olivia-dicorpo/birdfeeder/cad/README.md

# CAD

| Folder | What to open |
|---|---|
| `fusion/` | Fusion 360 `.f3z` / `.f3d` (source assemblies and body) |
| `step/` | Latest part exports for CAD interchange |
| `stl/` | Mesh exports for preview / print |
| `vendor/` | Bought-part models (SG90, McMaster torsion springs) |

See [docs/hardware.md](../docs/hardware.md) for the bill of materials and bounding-box sizes.
