olivia-dicorpo/birdfeeder/cad/step/spring-arm-left.step

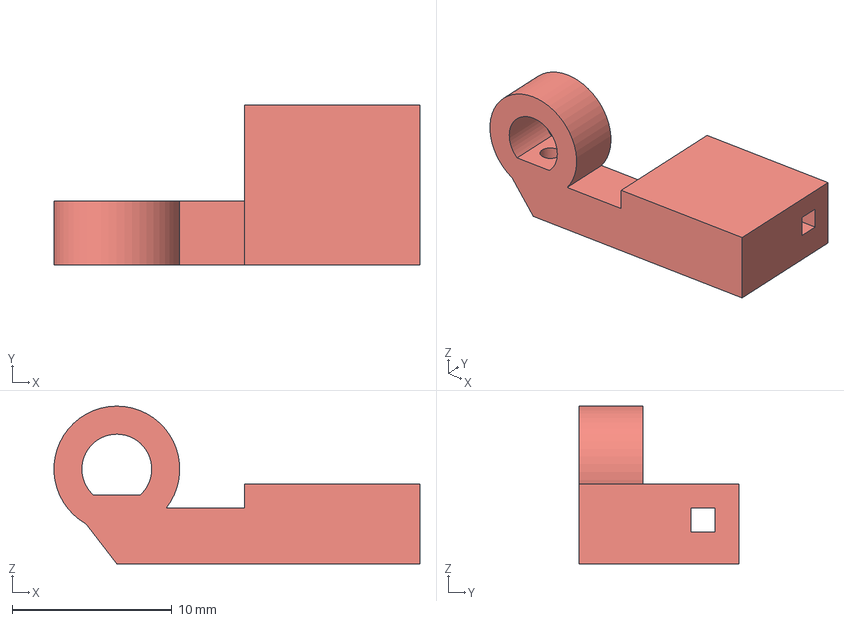
[picture p2: CAD file, 2026-10-11]
cad/step/spring-arm-left.step
22.9 x 10.0 x 9.89 mm
