olivia-dicorpo/birdfeeder/cad/stl/perch-new.stl

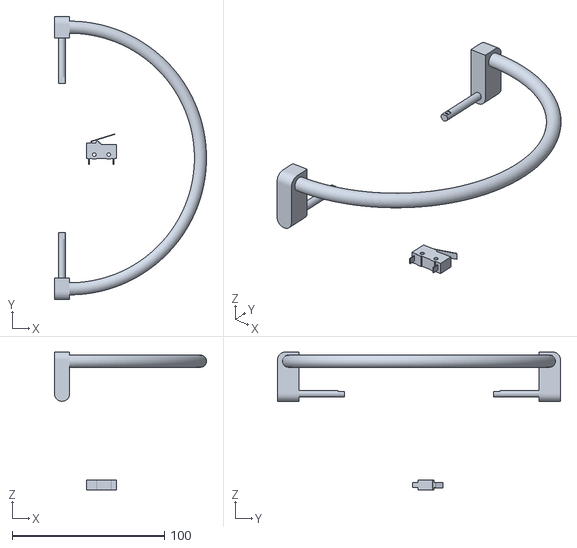
[picture p3: CAD file, 2026-10-11]
cad/stl/perch-new.stl
99.9 x 185.9 x 90.6
