olivia-dicorpo/birdfeeder/cad/step/base.step

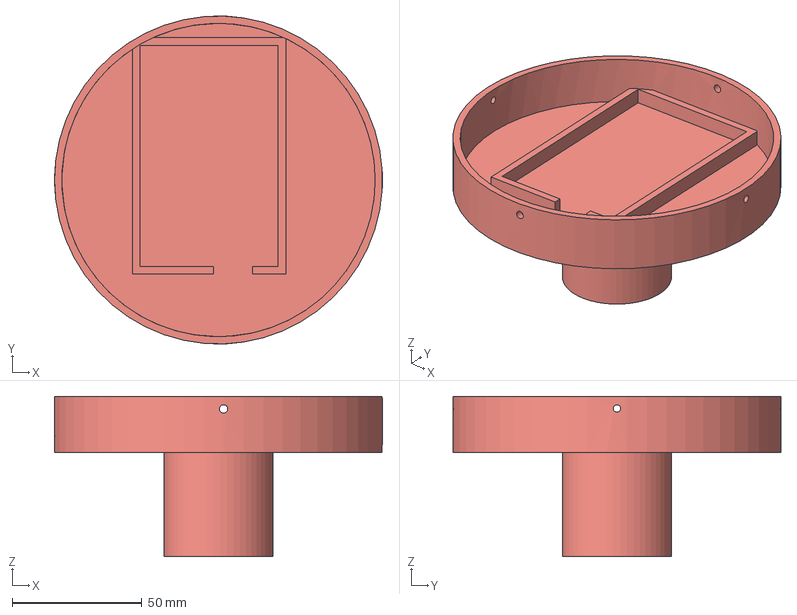
[picture p4: CAD file, 2026-10-11]
cad/step/base.step
126.2 x 126.2 x 61.7 mm
