olivia-dicorpo/birdfeeder/cad/stl/perch.stl

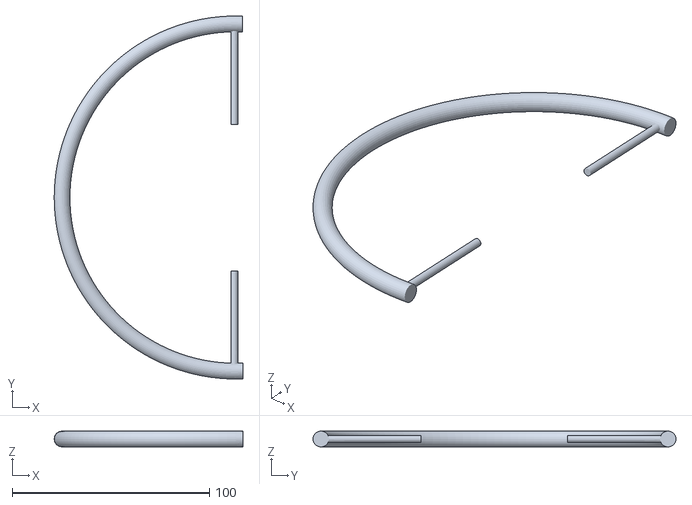
[picture p5: CAD file, 2026-10-11]
cad/stl/perch.stl
95.6 x 184.0 x 8.00
