olivia-dicorpo/birdfeeder/cad/step/perch-left.step

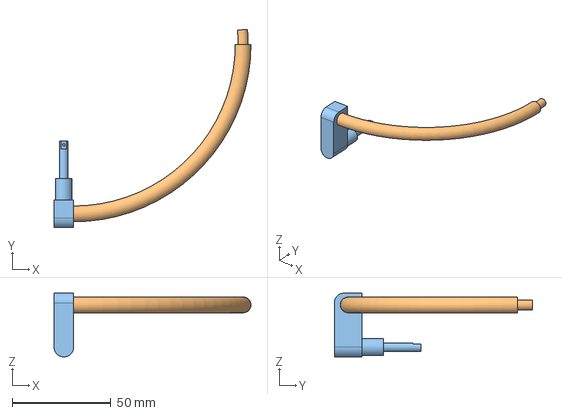
[picture p6: CAD file, 2026-10-11]
cad/step/perch-left.step
99.9 x 100.6 x 32.4 mm
