olivia-dicorpo/birdfeeder/cad/step/body-correct.step

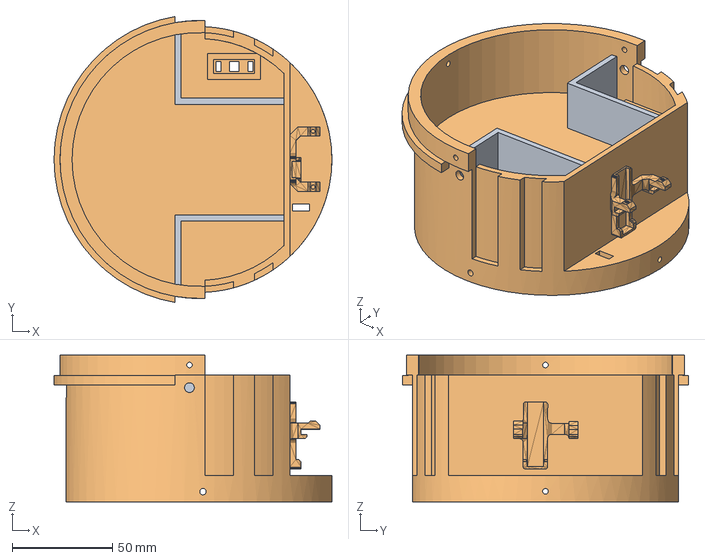
[picture p7: CAD file, 2026-10-11]
cad/step/body-correct.step
138.6 x 142.6 x 73.3 mm
