olivia-dicorpo/birdfeeder/cad/step/roof.step

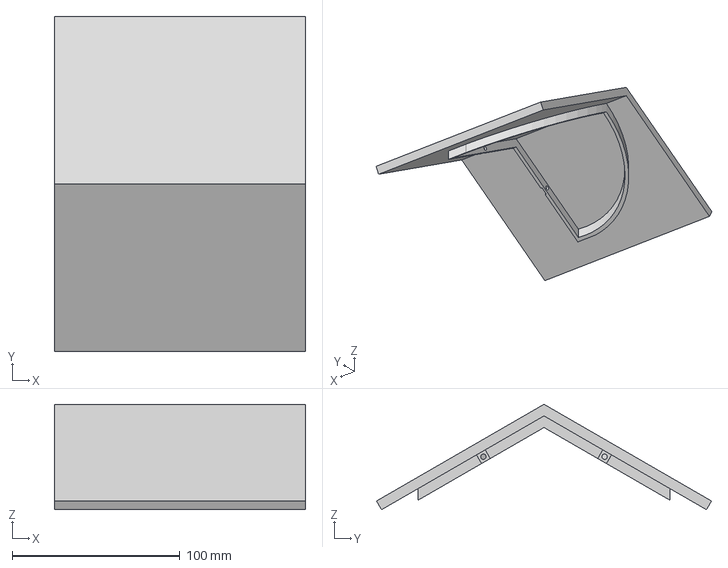
[picture p8: CAD file, 2026-10-11]
cad/step/roof.step
150.0 x 200.0 x 62.9 mm
