olivia-dicorpo/birdfeeder/cad/step/spring-arm-right.step

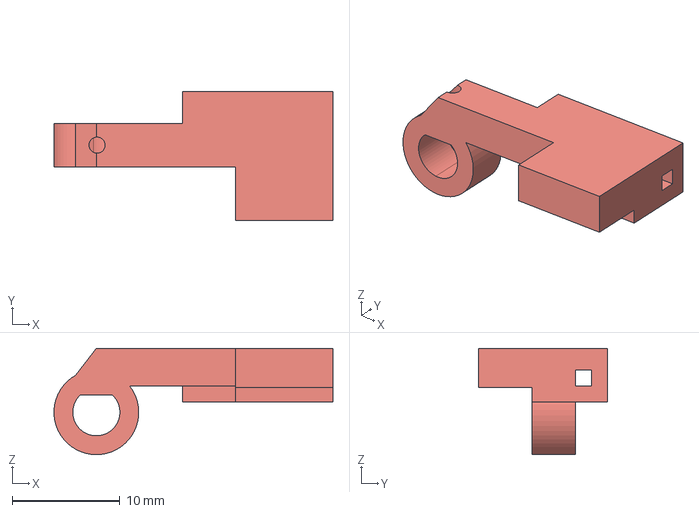
[picture p9: CAD file, 2026-10-11]
cad/step/spring-arm-right.step
25.9 x 12.0 x 9.89 mm
