olivia-dicorpo/birdfeeder/cad/step/perch-right.step

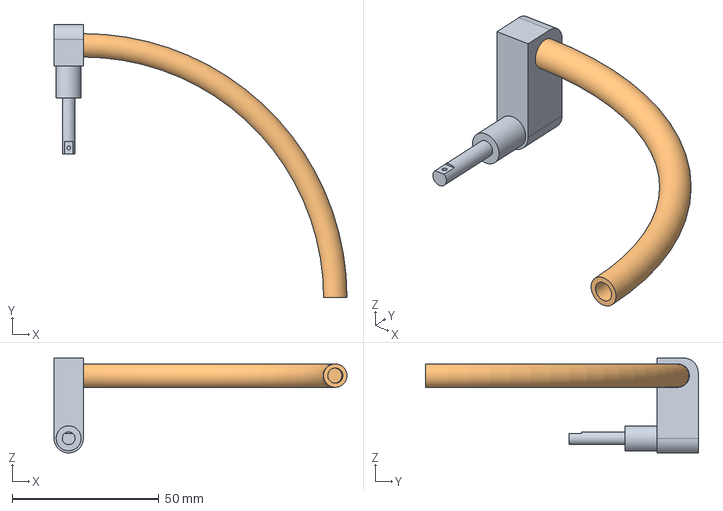
[picture p10: CAD file, 2026-10-11]
cad/step/perch-right.step
99.9 x 92.9 x 32.4 mm
