olivia-dicorpo/birdfeeder/cad/step/clear-seed-storage.step

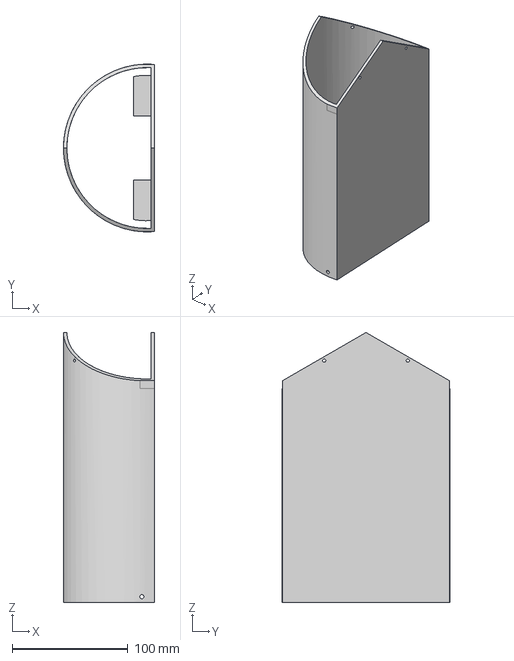
[picture p11: CAD file, 2026-10-11]
cad/step/clear-seed-storage.step
78.9 x 145.1 x 233.7 mm
