olivia-dicorpo/birdfeeder/cad/step/lid-correct.step

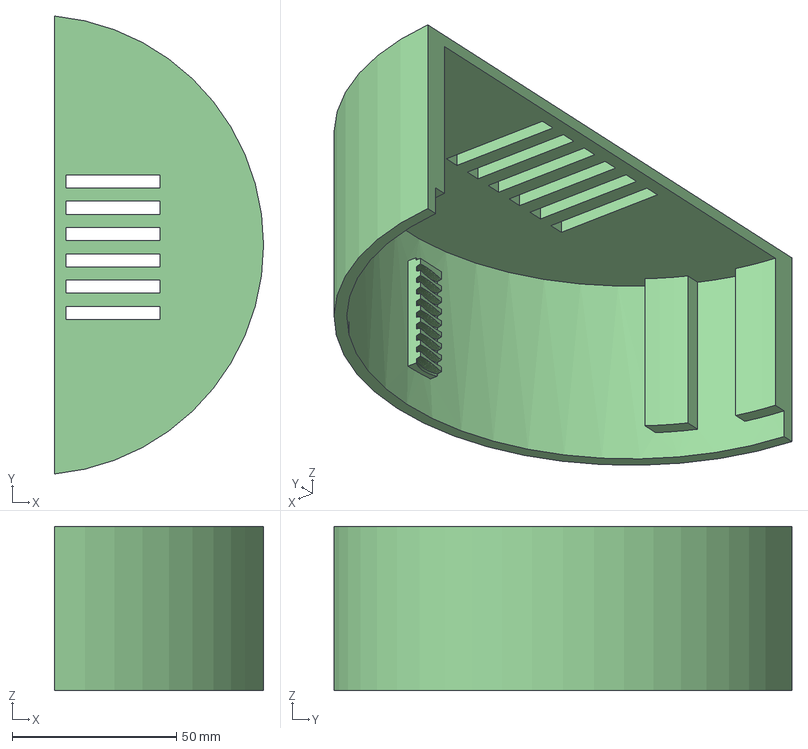
[picture p12: CAD file, 2026-10-11]
cad/step/lid-correct.step
63.7 x 139.4 x 50.0 mm
