olivia-dicorpo/birdfeeder/cad/step/actual-bird-feeder.step

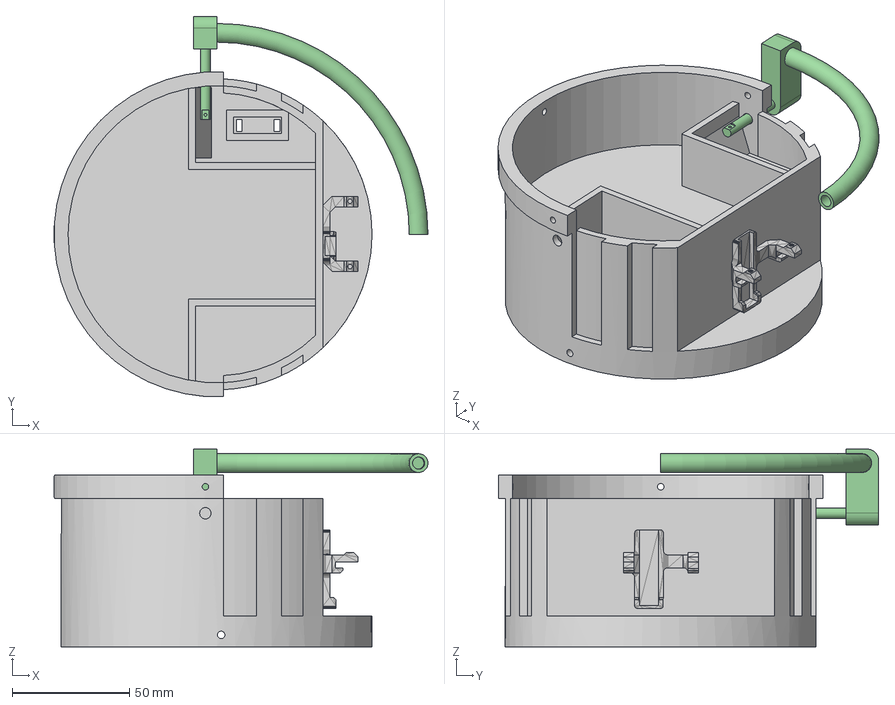
[picture p13: CAD file, 2026-10-11]
cad/step/actual-bird-feeder.step
159.4 x 162.2 x 84.4 mm
triangle
