olivia-dicorpo/birdfeeder/(list of files, cad)

Other CAD files:
cad/fusion/actual-bird-feeder.f3z
cad/fusion/birdfeeder-corrected.f3z
cad/fusion/body-correct.f3d
cad/stl/actual-bird-feeder.stl
cad/stl/lid-correct.stl
