olivia-dicorpo/birdfeeder/controller/test/tb.v

`default_nettype none
`timescale 1ns / 1ps

/* Birdfeeder door controller testbench.
 * Instantiates the Tiny Tapeout top and exposes named wires for cocotb / waves.
 *
 * RTL sims use a fast clock / short door timings so cocotb finishes quickly.
 * Gate-level sims use the hardened netlist as-is.
 */
module tb ();

  initial begin
    $dumpfile("tb.vcd");
    $dumpvars(0, tb);
    #1;
  end

  reg clk;
  reg rst_n;
  reg ena;
  reg [7:0] ui_in;
  reg [7:0] uio_in;
  wire [7:0] uo_out;
  wire [7:0] uio_out;
  wire [7:0] uio_oe;

  wire       arm       = ui_in[1];
  wire       diag_up   = ui_in[2];
  wire       diag_down = ui_in[3];
  wire [6:0] seg       = uo_out[6:0];
  wire       dp        = uo_out[7];
  wire       pwm_out   = uio_out[0];
  wire       pwm_oe    = uio_oe[0];
  wire       arm_alt   = uio_in[1];

`ifdef GL_TEST
  wire VPWR = 1'b1;
  wire VGND = 1'b0;

  tt_um_olivia_dicorpo_birdfeeder user_project (
      .VPWR(VPWR),
      .VGND(VGND),
      .ui_in  (ui_in),
      .uo_out (uo_out),
      .uio_in (uio_in),
      .uio_out(uio_out),
      .uio_oe (uio_oe),
      .ena    (ena),
      .clk    (clk),
      .rst_n  (rst_n)
  );
`else
  birdfeeder_top #(
      .CLK_FREQ(100_000),
      .OPEN_TIME_MS(1),
      .WAIT_TIME_MS(3),
      .CLOSE_TIME_MS(1)
  ) user_project (
      .ui_in  (ui_in),
      .uo_out (uo_out),
      .uio_in (uio_in),
      .uio_out(uio_out),
      .uio_oe (uio_oe),
      .ena    (ena),
      .clk    (clk),
      .rst_n  (rst_n)
  );
`endif

endmodule
