olivia-dicorpo/birdfeeder/(commit log)

2026-10-11 Add birdfeeder CAD, documentation, and a local copy of the hatch controller.
    Capture the Fusion/STEP design and point at olivia-dicorpo/birdfeeder-ctlr for the Tiny Tapeout Verilog.
    [actual-bird-feeder.f3z, actual-bird-feeder.step, actual-bird-feeder.stl, base.step, birdfeeder-corrected.f3z, body-correct.f3d, body-correct.step, clear-seed-storage.step]
2026-10-17 Add prototype photos and video of the assembled feeder.
    Put the still and clips in media/ and show the JPEG on the README so the build is visible on GitHub.
