olivia-dicorpo/birdfeeder/media/IMG_1682.jpg

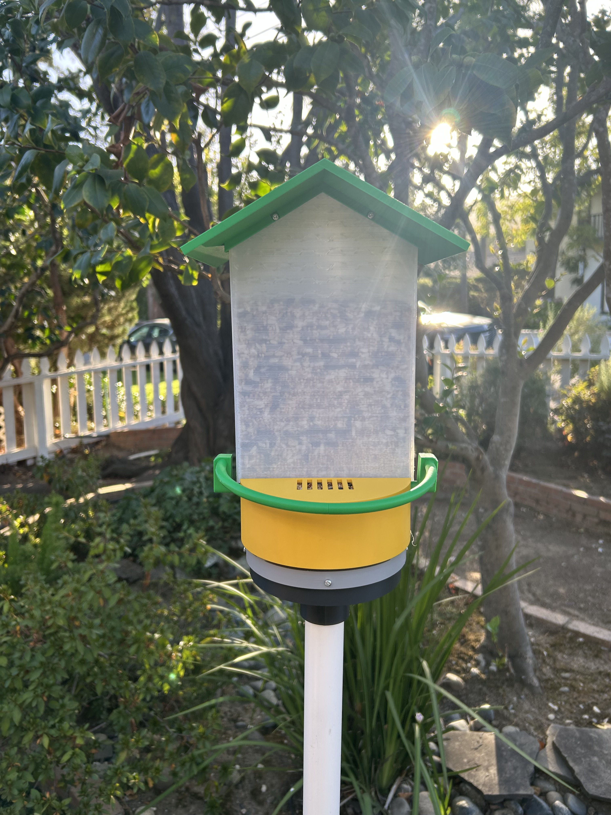
[picture p1: media/IMG_1682.jpg]
media/IMG_1682.jpg
